brunogle/me1-proyecto/informes/paper/main.pdf

# Lectura y procesamiento digital de senales ˜ electrocardiograficas ´

1

er Bruno Glecer

UTN - FRBA
Buenos Aires, Argentina
bglecer@frba.utn.edu.ar

2

do Uriel Sandomir

UTN - FRBA
Buenos Aires, Argentina
usandomir@frba.utn.edu.ar

3

ero Jonathan Yujra

UTN - FRBA
Buenos Aires, Argentina
jonathany@frba.utn.edu.ar
Abstract—La tecnica de la lectura de se ´ | nales el ˜ | ectricas produci- ´
das por el corazon se conoce como electrocardiograf ´ | ía, y es una
parte importante de la medicina moderna. En esta publicacion´ demostramos un circuito basico capaz de captar y digitalizar ´
senales card ˜ | íacas mediante el uso de un par de electrodos
colocados sobre un paciente, conocido como electrocardiografía
de unica derivaci ´ | on. ´
Index Terms—ECG, bioengineering, filtering, DSP
I. INTRODUCCION´
La tecnica de electrocardiograf ´ | ía (ECG) comienza en los
fines del siglo XIX con metodos basados en galvan ´ | ometros ´
especialmente sensibles y rapidos, con los que se fue de- ´ sarrollando los fundamentos de la electrocardiología. Estos
metodos fueron superados por electrocardi ´ | ografos que uti- ´
lizaban valvulas termoi ´ | onicas para la amplificaci ´ | on de las ´
senales, y estas fueron naturalmente remplazadas por el uso ˜ del transistor. Al día de hoy las senales t ˜ ípicamente son digitalizadas por un conversor analogico digital (ADC) y procesadas ´ digitalmente para mejorar su claridad. En la actualidad, existen metodos que un especialista puede utilizar para analizar el ´
estado de un corazon a base de las se ´ | nales obtenidas por un ˜
electrocardiografo, esto t ´ | ípicamente se realiza con mediciones
tomadas por multiples electrodos para lograr una mayor dis- ´
criminacion entre las actividades del ciclo card ´ | íaco. [1]

II. FUNDAMENTOS BIOLOGICOS ´

A. Origen de la actividad electrica del coraz ´ | on´
El corazon es un ´ | organo vital presente en la mayor ´ | ía de los
animales que cumple la funcion de circular sangre a trav ´ | es de ´
las arterias y venas con el fin de transportar oxígeno y nutrientes a la gran mayoría de las partes del cuerpo. El corazon´ esta principalmente compuesto por tejido muscular que se ´ contrae y relaja en forma coordinada, la secuencia en el que lo realiza se conoce como el ciclo cardíaco. Las contracciones
son causadas por senales el ˜ | ectricas producidas por el ´ | nodulo ´
sinoauricular. Debido a que la naturaleza de estas senales es ˜
electrica, y debido a que los tejidos h ´ | umedos incluyendo la ´
piel tienen una conductividad electrica considerable, es posible ´ realizar mediciones de estas senales de forma no invasiva ˜

Agradecemos a la Universidad Tecnologica Nacional por permitirnos el uso ´ de sus instalaciones y recursos para realizar nuestro proyecto, y a los docentes de la materia Medidas Electronicas I: Pablo De Cesare, Franco Zaccra y ´ Ramiro German Rodriguez Colmeiro por su apoyo durante el trabajo ´

mediante la colocacion de electrodos en la regi ´ | on cercana ´
al corazon. Observando las se ´ | nales es posible identificar las ˜
distintas etapas del ciclo cardíaco, y con suficiente pericia, reconocer la salud del organo. ´
Para mayor comprension, a continuaci ´ | on describiremos las ´
etapas mas importantes del ciclo card ´ | íaco y como se relacionan
con una senal electrocardiogr ˜ | afica: [2] ´
- Sístole auricular (Onda P): Durante esta etapa las cavidades superiores llamadas aurículas se contraen para enviar la sangre a las respectivas cavidades inferiores llamadas ventrículos. La aurícula derecha recibe sangre desoxigenada del cuerpo, mientras la aurícula izquierda recibe sangre recientemente oxigenada, directo de los pulmones.
Este evento da origen a una senal denominada ˜ | onda P
- Sístole ventricular (Complejo QRS): Durante esta etapa los ventrículos se contraen para expulsar la sangre al
exterior del corazon. El ventr ´ | ículo derecho envía su
sangre desoxigenada hacia los pulmones, mientras que el ventrículo izquierdo envía su sangre oxigenada al resto del cuerpo. Esta etapa es compleja, y su representacion´ electrica puede variar, pero suele estar compuesta por un ´
pico negativo pequeno denominado ˜ | onda Q, seguido de
un pulso positivo de alta amplitud denominado onda R y seguido de otro pulso negativo denominado onda S. El conjunto de estas tres ondas, se las denomina complejo QRS.
Dependiendo del estado del corazon, la onda Q y la onda ´ S pueden estar o no presentes, mientras que la onda R siempre esta presente y corresponde al punto de mayor
actividad electrica del coraz ´ | on en todo su ciclo. ´
- Diastole Ventricular (Onda T) ´ | : En esta etapa los
ventrículos se relajan, preparando el corazon para el sigu- ´
iente ciclo. La relajacion de los ventr ´ | ículos se presenta
electricamente como una onda similar a la onda P. A esta ´ onda se la denomina onda T.
En la figura 1 se muestra un diagrama de una senal ECG ˜ típica.
B. Características de la senal el ˜ | ectrica ´
Las senales el ˜ | ectricas captadas por los electrodos tienen ´
amplitudes en el rango de 1-3 mV, dependiendo de la ubicacion´
de los electrodos, su tamano, caracter ˜ | ísticas de la piel del

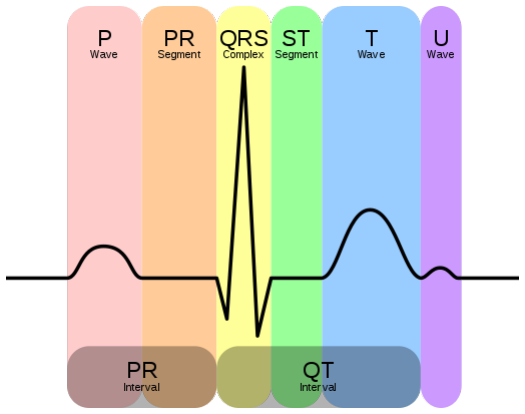
[picture p26: figure]

Fig. 1. Ejemplo de una senal de ECG t ˜ | ípica. La ultima onda ”U” no suele ´
ser visible debido a su pequena amplitud, y su naturaleza no est ˜ | a totalmente ´
comprendida.

paciente, entre otros factores difíciles de controlar. Ademas, ´
se conoce que el rango de frecuencias de interes de la se ´ | | nal ˜
es de entre 0.05 Hz y 200 Hz. Por otro lado, la impedancia de salida de la senal puede rondar los cientos de kiloohmios, ˜ lo cual exige una impedancia de entrada alta para el correcto funcionamiento de un electrocardiografo. [3] [4] ´

III. METODOLOGÍA GENERAL

A. Objetivo de medicion´
Nuestra meta para este trabajo fue el diseno y construcci ˜ | | on´
de un electrocardiografo capaz de captar una se ´ | nal card ˜ | íaca
con la suficiente calidad para lograr distinguir la onda P, T y el complejo QRS y de mostrar los valores temporales y de amplitud lo mas precisamente posible. ´
Por simplicidad, se eligio que su entrada sea de ´ | unica ´
derivacion (un solo par de electrodos). ´
B. Acondicionamiento analogico ´
La senal captada por los electrodos debe ser amplificada y ˜
filtrada analogicamente antes de ser digitalizada. La elecci ´ | | on´
de la primera etapa de amplificacion es cr ´ | ítica: es especial-
mente importante que sea de bajo ruido, debido a la pequenã
senal de entrada, y tiene que operar con m ˜ | | | ínimo consumo
de corriente de polarizacion de entrada, debido a la alta ´ impedancia de salida de la senal. ˜
El diseno de esta etapa puede ser complicada y requiere ˜ implementarse en un PCB con consideraciones de disenõ especiales. Para optimizar el proceso, decidimos reutilizar un
modulo para captar se ´ | nales biol ˜ | ogicas dise ´ | nado y armado ˜
por el grupo de investigacion´ GIBIO en la UTN-FRBA. Este
modulo ya tiene dise ´ | nada una etapa de entrada completa que ˜
podemos utilizar para este proposito y un ADC espec ´ | ífico para
captar senales de ECG, pero desafortunadamente el ADC no ˜ se encontraba funcionando correctamente, entonces nos vimos obligados a utilizar un ADC externo.
El modulo consiste de una etapa de entrada utilizando ´ el amplificador operacional ADA4530 fabricado por Analog Devices como primera etapa, seguido de una etapa de filtrado de altas frecuencias, seguido de una etapa de ganancia configurable mediante el uso de resistencias variables y finalmente una etapa para desplazar la senal hacia valores positivos y ˜ centrarla en 1.65 V, esto es necesario, ya que la referencia negativa del ADC es de 0 V.
El amplificador operacional ADA4530 [5] es un perfecto candidato para la primera etapa de amplificacion. Tiene una ´
corriente de polarizacion de entrada de 20 fA. Adem ´ | as, ´
proporciona un terminal de ”guard” que permite reducir las
perdidas parasitas de la se ´ | nal hacia la masa del circuito. ˜
La figura 2 muestra el esquematico simplificado del m ´ | odulo ´
analogico. ´
Un problema de diseno de este m ˜ | odulo, es que no tiene una ´
frecuencia de corte superior lo suficientemente baja como para actuar de filtro anti-alias. Esto puede ser perjudicial para nue-
stro objetivo y una nueva iteracion del circuito resolver ´ | ía este
error, sin embargo, no se cree que esta falla del diseno cause ˜ mayores complicaciones, debido a que las unicas componentes ´ espectrales por encima de la frecuencia de Nyquist del ADC y por debajo de la frecuencia de corte del modulo, consisten de ´ ruido uniformemente distribuido, lo cual en efecto, introducirá

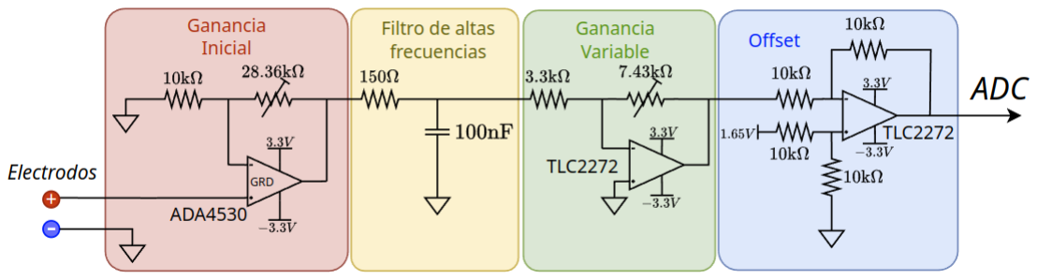
[picture p27: figure]

Fig. 2. Esquematico simplificado de la etapa anal ´ | ogica del m ´ | odulo desarrollado por el GIBIO en la UTN-FRBA. ´

mas ruido en la conversi ´ | on, pero no causar ´ | a artefactos de alias ´
que puedan confundirse con la senal ECG. ˜
Dos de las etapas tienen ganancia ajustable mediante el uso de resistencias variables. Estas resistencias fueron ajustadas y luego medidas, sus valores se encuentran en la figura 2, estos
valores daran lugar a una ganancia te ´ | orica de 8.631 veces. ´
Este valor fue el utilizado para realizar la calibracion m ´ | as´
adelante. Su valor exacto no es de gran importancia, ya que la
calibracion contempla la compensaci ´ | on por su incertidumbre ´
C. Conversion A/D ´
Para convertir la senal anal ˜ | ogica entregada por el m ´ | odulo ´
analogico a una se ´ | nal digital necesitamos de un ADC capaz ˜
de muestrear como mínimo al doble de la frecuencia maxima ´ presente en una senal ECG (alrededor de 400 muestras por ˜ segundo) para cumplir con el criterio de Nyquist y con una resolucion menor a 1 mV para lograr una buena calidad de la ´ senal. ˜
Se decidio utilizar el ADC ADS1115 de Texas Instruments ´
[6] que adquirimos ya montando sobre una placa con los componentes auxiliares que necesita el circuito integrado ya colocados.
Este ADC tiene una frecuencia de muestreo maxima de 860 ´ muestras por segundo, resolucion de 16 bit y una interfaz I ´

2C.
Este ADC fue elegido por su gran disponibilidad, facilidad de uso y tambien porque cumple con nuestro requisito de ser ´ capaz de muestrear por arriba de los 400 Hz.
El ADS1115 fue configurado en modo single-shot para utilizar la base de tiempo del microcontrolador. Estara operando ´
a 500 muestras por segundo. En terminos de resoluci ´ | on, la ´
tension de referencia positiva fue configurada para utilizar ´ la referencia interna de 4.096 V, y 0 V como referencia
negativa. Esta configuracion permite una resoluci ´ | on te ´ | orica de ´
4.096V
2

16 = 62.5µV .

D. Interfaz PC-ADC

Para configurar y comunicar los resultados del ADS1115 con una computadora, es necesario el uso de un microcontrolador. Decidimos utilizar una placa de desarrollo de ST Microelectronics: La Nucleo F401-RE [7]. Esta placa está basada sobre un microcontrolador STM32F401RE, este es un ARM Cortex-M4 de 32 bit con una frecuencia de reloj maxima ´ de 84 MHz. Este microcontrolador esta sobredimensionado ´
para esta aplicacion, pero aun as ´ | í lo utilizamos porque el
grupo ya tenía experiencia previa con esta placa de desarrollo en particular y lo pudimos obtener con facilidad mediante la universidad.
De este microcontrolador utilizamos principalmente un puerto I²C para la comunicacion con el ADS1115, un timer ´
interno con una interrupcion para poder iniciar una conversi ´ | on´
con una frecuencia de 500 Hz y un puerto UART que la placa de desarrollo utiliza para crear un enlace con la PC mediante el puerto USB.
El programa ejecutandose en el microcontrolador realiza la ´
configuracion inicial del ADS1115, su lectura peri ´ | odica y la ´

transmision de los resultados de las conversiones del ADC ´ mediante un puerto serie.
El codigo fuente y los binarios utilizados se encuentra en ´ el repositorio del proyecto. [8]
E. Software PC
Para la visualizacion de la se ´ | nal, se desarroll ˜ | o una interfaz ´
grafica programada en Python utilizando la librer ´ | | ía PyQt5.
El programa recibe los datos de las conversiones del ADC mediante la interfaz del puerto serie establecido a traves de ´ USB con el microcontrolador.
La senal recibida por la PC en este punto del proceso ˜ tiene una mala relacion se ´ nal a ruido, dificultando mucho su ˜ visualizacion. Para mejorar esto se emplea el uso de filtros ´ digitales para reducir el ruido, en particular, los ruidos que
típicamente estan presentes en la se ´ | nal son: Interferencias de ˜
50 o 60 Hz causado por la frecuencia de línea, ruido de baja frecuencia causado por cambios en la conductividad electrica ´ de la piel del paciente y ruido en todo el espectro causado por varias fuentes de interferencia.
Para mitigar cada una de estas fuentes de ruido, utilizamos dos tipos de filtros digitales en cascada. Primero, se aplica un filtro notch con frecuencia central de 50 Hz y selectividad de 2. Y segundo, un filtro Butterworth pasabanda de segundo orden con frecuencias de corte en 0.5 Hz y 100 Hz. Excepto por la frecuencia central del primer filtro notch, los otros valores fueron elegidos experimentalmente para mejorar la claridad de la senal. Los valores del filtro pasa banda recortan parte del ˜
espectro de interes de la se ´ | nal, aun as ˜ | í, la reduccion de ruido ´
que acompana esta limitaci ˜ | on beneficia la claridad de la se ´ | nal. ˜


Fig. 3. Fotografía del proyecto en su gabinete.

IV. CALIBRACION´

A. Necesidad

El electrocardiografo desarrollado tiene varias fuentes de ´ incertidumbre, las mas relevantes son la transferencia entre la ´ entrada y la senal digitalizada, y la base de tiempo utilizada ˜

para muestrear la senal. Para que las interpretaciones del elec- ˜ trocardiograma puedan ser precisas es necesario tener buena linealidad en la transferencia y temporizaciones precisas. El objetivo de la calibracion es obtener dos factores: Un factor ´
de correccion temporal que denominaremos ´ | αT , que especifica
proporcionalmente cuanto esta desviada la base de tiempo del ´
electrocardiografo, y un factor de calibraci ´ | on de amplitud que ´
denominaremos αA, que especifica la diferencia relativa entre la ganancia teorica del sistema y la real. ´
Una vez que se obtienen estos valores, cualquier analisis que ´
se realice sobre una senal obtenida por el electrocardi ˜ | ografo, ´
se puede corregir multiplicando por el factor de correccion´ que corresponda al tipo de medicion. ´
Otra necesidad de conocer con exactitud la base de tiempo es para el uso de los filtros. Estos depende de conocer con precision la frecuencia de muestreo del ADC. El rendimiento ´ del filtro notch de 50 Hz es particularmente sensible a una desviacion en la frecuencia de muestreo. ´
B. Metodo ´
Para evaluar el desempeno del electrocardi ˜ | ografo, se utiliz ´ | ó
un generador de funciones Agilent 33522A con su calibracion´
de fabrica como referencia para generar una se ´ | nal electrocar- ˜
diografica de duraci ´ | on y amplitud conocida. ´
El instrumento se controlo mediante un script en Python que ´ itera por varias opciones de amplitud y frecuencia cardíaca, cargando la senal al instrumento el cual su salida fue conectada ˜ directamente a la entrada del electrocardiografo. Para cada una ´ de estas configuraciones de frecuencia cardíaca y amplitud se tomaron 10 muestras de 10 segundos cada una utilizando el electrocardiografo y fueron guardadas en archivos para luego ´ procesar.
Una vez obtenidas las senales se les aplic ˜ | o los mismos filtros ´
que el programa de la visualizacion utiliza para limpiar la ´ senal. ˜
Las senales proporcionadas al generador de ondas arbi- ˜ trario fueron sintetizadas utilizando la librería de Python neurokit2. [9] Esta misma librería se utilizo luego para ´
analizar las senales captadas por el electrocardi ˜ | ografo. ´
De las senales captadas se midieron dos par ˜ | ametros para ´
estudiar el rendimiento:
Primero, la frecuencia cardiaca, este valor es un parametro ´
biologico clave estudiado en la electrocardiograf ´ | ía, y ademas´
proporciona un valor que tiene una correlacion perfectamente ´ lineal con la base de tiempo del electrocardiografo, una ´ posible fuente de error. Fue medido utilizando la funcion´
ecg_process de neurokit2 con el metodo de detecci ´ | on´
de picos ”engzeemod2012” y promediando el valor de ritmo cardíaco a lo largo del vector de salida.
Y como segundo parametro, se midi ´ | o la diferencia entra la ´
amplitud promedio de los pulsos R y la amplitud promedio de los pulsos S. Los pulsos tambien fueron detectados utilizando ´
la funcion´ ecg_process con el mismo metodo de detecci ´ | on´
de picos que su uso para obtener la frecuencia cardiaca. Este ´
parametro es ´ | util, debido a que representa una buena medici ´ | on´
de la amplitud pico a pico de la senal, ya que los pulsos S ˜
son los puntos mas bajos de la se ´ | nal y los pulsos R los m ˜ | as´
altos.
La calibracion se realiz ´ | o para las frecuencias cardiacas de: ´
50, 75, 100, 200 y 250 latidos por minuto, y amplitudes de 0.002, 0.005, 0.01, 0.02 y 0.1 V. Para cada una de estas combinaciones se realizaron 10 muestras de 10 segundos cada una, resultando en un total de 250 muestras. La mitad de estas muestras fueron destinadas para la calibracion, mientras que ´
la otra mitad se utilizo para la verificaci ´ | on de la calibraci ´ | on. ´
Es importante no reutilizar las mismas muestras para calibrar
y para verificar debido a que esto producira una verificaci ´ | on´
de la calibracion sesgada. ´
Una vez que se obtuvieron las mediciones de la calibracion, ´ estos se compararon con los valores teoricos para calcular ´ ambos factores de correccion. ´
Mas espec ´ | íficamente, cada factor se calculo utilizando la ´
media aritmetica de todos los errores relativos: ´

αT =

1
N

X

(a,f,n)∈A×F ×{1...10}

f

ˆf(a,f,n)

αA =

1
N

X

(a,f,n)∈A×F ×{1...10}

a

â(a,f,n)

Donde A y F son respectivamente los conjuntos de amplitudes y frecuencias cardiacas utilizadas para calibrar. ˆf(a,f,n)
y â(a,f,n) es el valor medido durante la calibracion de la ´ | n-
esima muestra para una amplitud de a y frecuencia cardíaca de f. N = 125 es la cantidad total de muestras medidas (5 frecuencias cardiacas, 5 amplitudes y 5 muestras por combinacion). ´
Ademas, para cada uno de estos factores, es relevante ´ conocer su incertidumbre, para esto calculamos el desvío
estandar de la media de cada uno. Las f ´ | ormulas utilizadas ´
son las siguientes:


Fig. 4. Calibracion del proyecto en progreso. La medici ´ | on de las 250 muestras ´
demoro aproximadamente una hora. ´

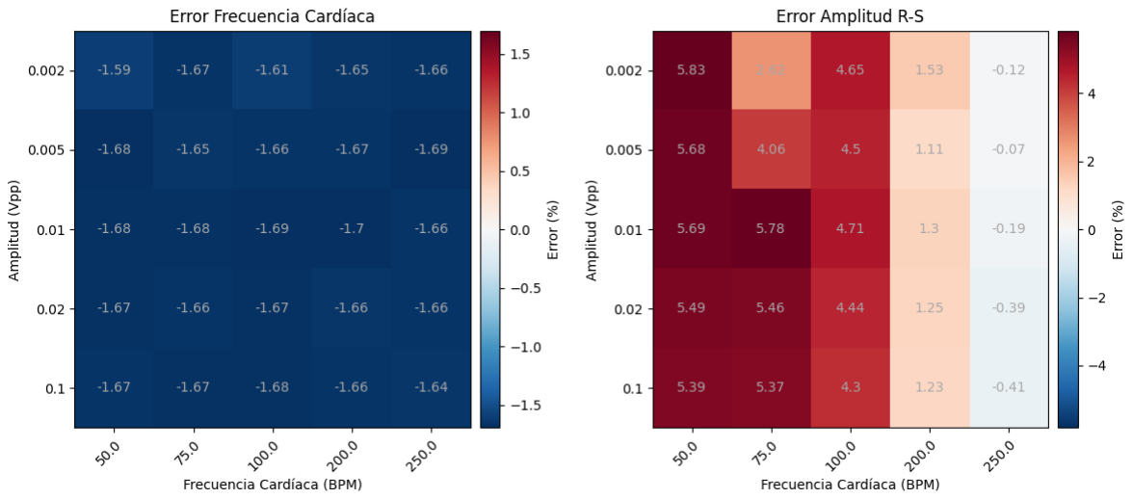
[picture p28: figure]

Fig. 5. Mapa de error de medicion sin la calibraci ´ | on aplicada. ´

u

2

(αT ) = 1 N − 1
X

(a,f,n)∈A×F ×{1...10}

f

ˆf(a,f,n)

− αT

!2

u

2

(αA) = 1 N − 1
X

(a,f,n)∈A×F ×{1...10}

a

â(a,f,n)

− αA

2

En todos los casos, la incertidumbre se dara en forma ´ expandida con un factor de cobertura k = 2, es decir, con una confianza del 95%:

U(α) = ku(α)

Una vez que se obtienen estos factores de calibracion, se ´ pueden utilizar para ajustar cualquier medicion realizada con ´ el electrocardiografo utilizando las siguientes conversiones: ´

F

′ = αT F

T

′ =

T
αT

A

′ = αAA

Donde F indica algun par ´ ametro frecuencial medido, como ´ ser pulsaciones por minuto, T indica un parametro temporal ´
medido como ser separacion entre pulsos, y ´ | A indica un
parametro de amplitud. ´ | F

′
, T

′ y A′
indican los valores
corregidos de F, T y A respectivamente.
Otra forma de aplicar una correccion es modificar la se ´ | nal ˜
previo al analisis de la siguiente forma: ´

v

′
(t) = αA v(αT t)
Donde v(t) representa la senal original y ˜ | v

′
(t) la senal ˜
corregida.
C. Resultados de la calibracion´
La figura 5 muestra para cada frecuencia y amplitud, el
error relativo medio entre la medicion de cada par ´ | ametro, y el ´
esperado.
Analizando cualitativamente el grafico de error de frecuen- ´ cia cardíaca, vemos que este es muy consistente a lo largo de las frecuencias y amplitudes probadas, todos los valores de error estan dentro de un rango del 1.6% al 1.7%. ´
De lo contrario, vemos que el error de amplitud no es consistente y varía dependiendo de la frecuencia cardíaca. Utilizando las ecuaciones planteadas en la subseccion ante- ´ rior, procedemos a calcular los factores de correccion. ´

αT = 1.01692 ± 0.00088

αA = 0.969 ± 0.048

D. Rendimiento de la calibracion´
Una vez obtenido los factores de correccion, estos valores ´ se pueden utilizar para refinar el desempeno del electro- ˜
cardiografo calibrado. Procedemos a realizar el mismo an ´ | alisis ´
que se realizo para la calibraci ´ | on con el paso adicional de ´
aplicar los factores de correccion previo al an ´ | alisis de las ´
senales. ˜
Esto resulta en el mapa de error visualizado en la figura 6. Los errores de la frecuencia cardíaca se encuentran dentro de un rango del -0.04% al 0.02%, mientras que los errores de
amplitud tienen mas dispersi ´ | on y, como es de esperar, siguen ´
manteniendo la correlacion entre error y frecuencia card ´ | íaca
que se observo previo a la calibraci ´ | on. Los valores de este ´
parametro existen en el rango de -3.6% al 2.9%. ´

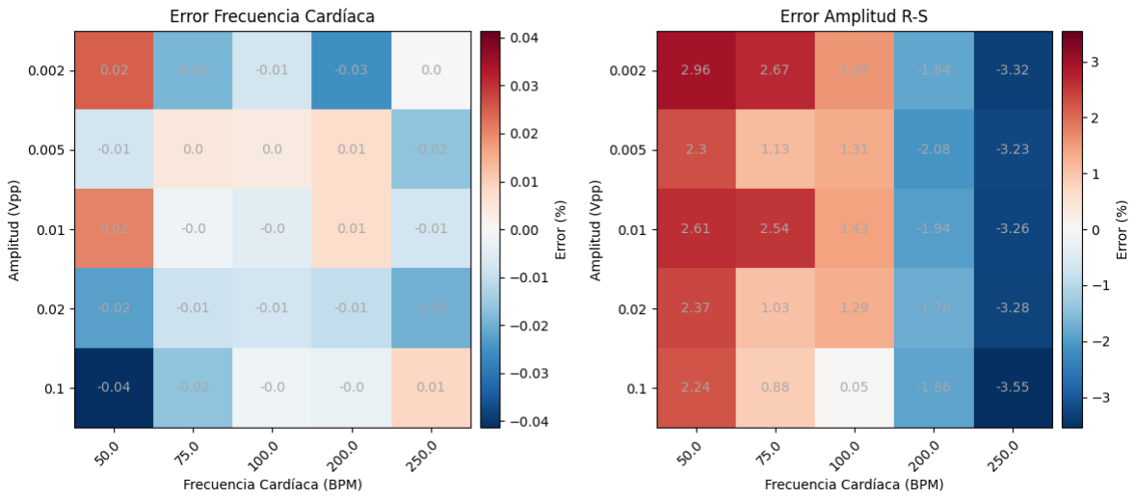
[picture p29: figure]

Fig. 6. Mapa de error de medicion con la calibraci ´ | on aplicada. ´

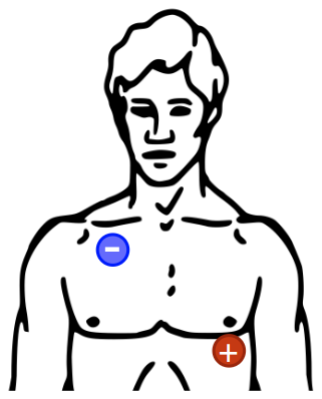
[picture p30: figure]

Fig. 7. Diagrama de la colocacion recomendada de los electrodos. ´

V. PRUEBA DE UNA MEDICION REAL ´

Una vez obtenidos los factores de correccion, estos fueron ´
cargados al programa que se describio en la secci ´ | on III-E. ´
La ubicacion de los electrodos es una parte cr ´ | ítica de la
electrocardiografía, basandonos en la literatura y realizando ´ comparaciones cualitativas de la calidad de la senal obtenida, ˜ determinamos que la mejor colocacion de los electrodos para ´ este caso es la ilustrada en la figura 7
Una vez ubicados los electrodos, y conectados al electrocardiografo se puede utilizar el programa para visualizar la ´ senal obtenida. ˜
En la figura 8 se muestra una captura de pantalla del graficador mostrando la senal ECG captada de uno de los ˜ integrantes del proyecto.

VI. CONCLUSIONES

Analizando el error de frecuencia cardíaca previo a la calibracion se puede observar en el mapa de error de la figura ´

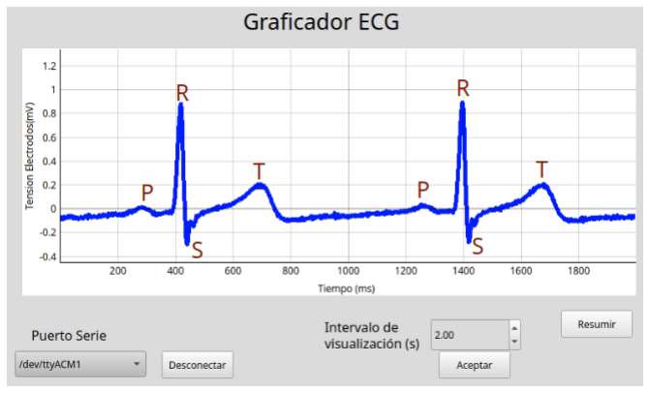
[picture p31: figure]

Fig. 8. Captura de pantalla tomada por la medicion del electrocardi ´ | ografo ´
sobre uno de los integrantes del grupo. Se etiquetaron los pulsos claves.

6 que no varía dependiendo de frecuencia cardiaca ni de la amplitud. Esto es un indicador fuerte de que la fuente de esta diferencia es la frecuencia a la que el ADC se encuentra muestreando. Un estudio del microcontrolador podría dar mas´
informacion al respecto. Luego de la calibraci ´ | on, el error de ´
frecuencia cardiaca permanece debajo del 0.04%, una cifra muy buena indicando consistencia entre diferentes condiciones de medicion. ´
En terminos de la amplitud, la correlaci ´ | on negativa del valor ´
medido con la frecuencia cardiaca puede ser un indicio de que la senal alcanza su valor pico entre dos muestras del ADC. El ˜ comportamiento esperado de esta situacion es que disminuya ´ con un incremento de frecuencia, que es precisamente lo que se observa que sucede. Para estudiar esto es necesario analizar
la forma de onda con mas precisi ´ | on y remplazar el ADC ´
por uno que soporte frecuencias de muestreo mas altas. La ´

calibracion ayud ´ | o a que el error de amplitud se encuentre ´
mas uniformemente disperso entre las distintas frecuencias ´ cardíacas.
Otro valor de interes para observar es la incertidumbre de los ´ factores de correccion. Como es de esperar, la incertidumbre ´ relativa de αT es extremadamente bajo, alrededor de 0.08%, indicando que las mediciones de tiempo son muy precisas. En cambio, la incertidumbre relativa de αA es aproximadamente 11%.
La prueba de medicion de una se ´ | nal ECG real result ˜ | ó
sorprendentemente exitosa, la visualizacion de la se ´ | nal permite ˜
identificar con claridad los pulsos P, R, S y T. El pulso Q no aparenta estar presente, esto se puede deber a una
combinacion de factores, incluyendo la colocaci ´ | | on de los ´
electrodos y el estado del paciente, no necesariamente indica
una limitacion del electrocardi ´ | ografo. Aun as ´ | í, no descartamos
la posibilidad de que simplemente se mezcle con el ruido, esto podría verificarse utilizando un equipo electrocardiografico ´ profesional.

REFERENCES

[1] L. | J. | AlGhatrif | M, | “A | brief | review: | history | to | un-
derstand | fundamentals | of | electrocardiography,” | J | Community
Hosp | Intern | Med | Perspect., | 2012. | [Online]. | Available:
https://www.ncbi.nlm.nih.gov/pmc/articles/PMC3714093/
[2] N. J. Ashley EA, Cardiology Explained. Remedica, 2004. [Online]. Available: https://www.ncbi.nlm.nih.gov/books/NBK2214/
[3] Q. | U. | D. | of | Emergency | Medicine, | “Analy-
sis | and | interpretation | of | the | electrocardiogram.” | [On-
line]. Available: https://elentra.healthsci.queensu.ca/assets/modules/tsecg/normal ecg.html
[4] Z. B. Murugappan M, Murugappan S, “Frequency band analysis of electrocardiogram (ecg) signals for human emotional state classification using discrete wavelet transform,” J Phys Ther Sci., 2013. [Online]. Available: https://www.ncbi.nlm.nih.gov/pmc/articles/PMC3820413/
[5] A. | Devices, | “Data | sheet | ada4530-1.” | [Online]. | Avail-
able: | https://www.analog.com/media/en/technical-documentation/data-
sheets/ADA4530-1.pdf
[6] T. | Instruments, | “Data | sheet | ads111x.” | [Online]. | Available:
https://www.ti.com/lit/ds/symlink/ads1114.pdf
[7] “Stm32 | nucleo-64 | development | board.” | [Online]. | Available:
https://www.st.com/en/evaluation-tools/nucleo-f401re.html
[8] “Trabajo practico - medidas electr ´ | onicas 1.” [Online]. Available: ´
https://github.com/brunogle/me1-proyecto
[9] “Neurokit2: The python toolbox for neurophysiological signal processing.” [Online]. Available: https://github.com/neuropsychology/NeuroKit
