brunogle/me1-proyecto/soft/calibration/output/amplitude_corr.png

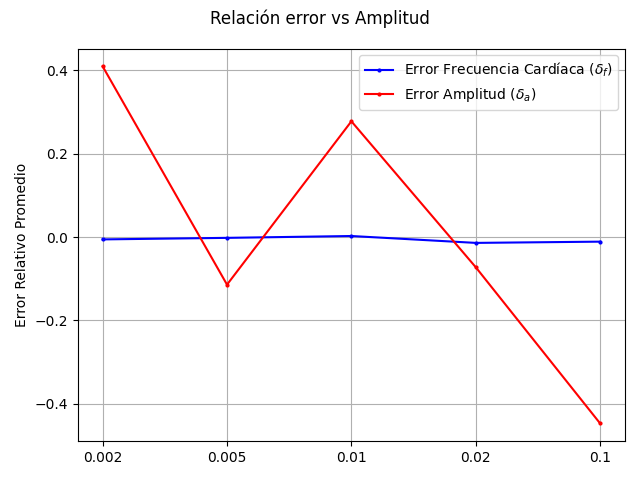
soft/calibration/output/amplitude_corr.png
