brunogle/me1-proyecto/soft/calibration/output/heart_rate_corr.png

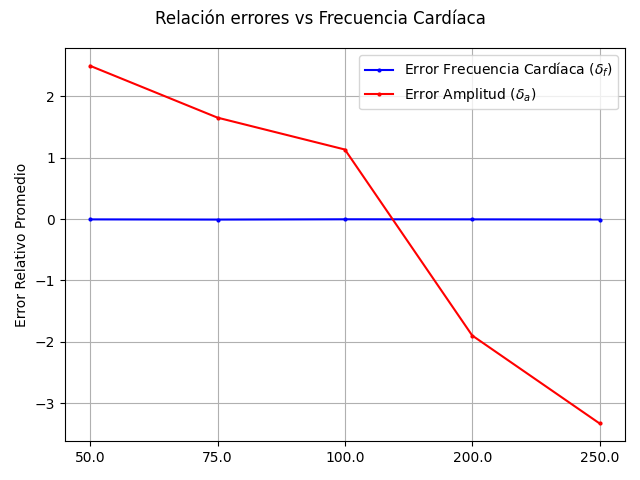
soft/calibration/output/heart_rate_corr.png
