brunogle/me1-proyecto/design/adquisidor-master/FrontEnd/FrontEnd.kicad_pcb

## KiCad design design/adquisidor-master/FrontEnd/FrontEnd.kicad_pcb (2023-10-05, last stored version)

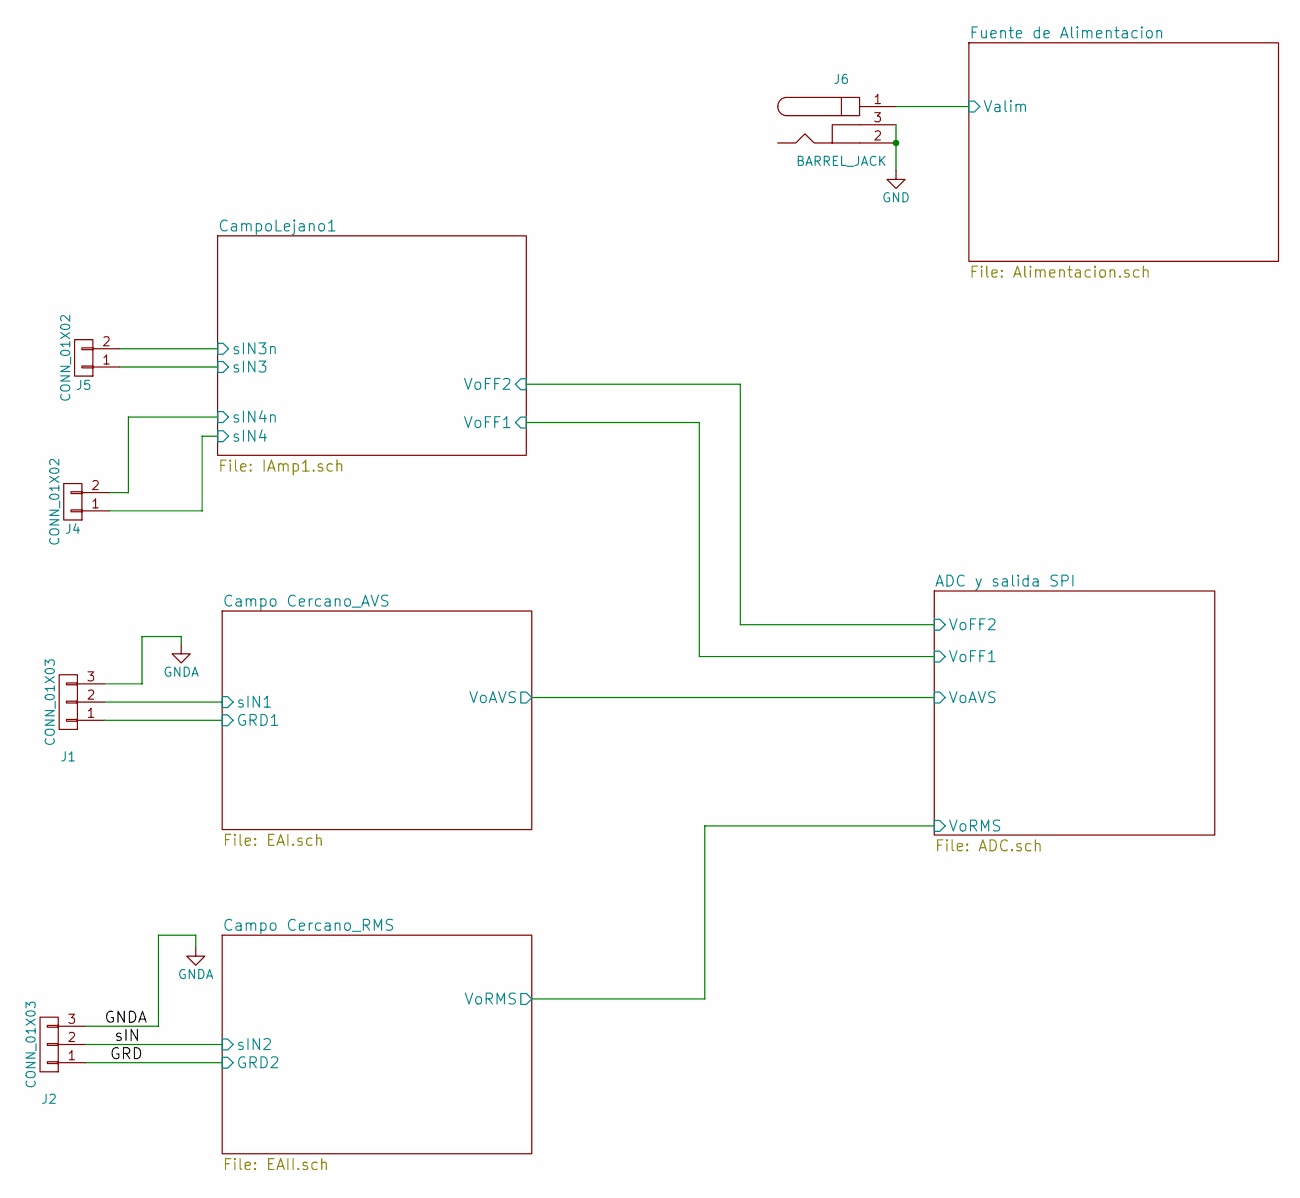
[picture p55: schematic FrontEnd.sch]

Parts:
J1, J2: CONN_01X03; Triaxial_PAD
J4, J5: CONN_01X02; TerminalBlock_bornier-2_P5.08mm
J6: BARREL_JACK

Connections:
+5V: J6.1; also elsewhere on the board
/Campo Cercano_AVS/GRD1: J1.1; also elsewhere on the board
/Campo Cercano_AVS/sIN1: J1.2; also elsewhere on the board
/Campo Cercano_RMS/GRD2: J2.1; also elsewhere on the board
/Campo Cercano_RMS/sIN2: J2.2; also elsewhere on the board
/CampoLejano1/sIN3: J5.1; also elsewhere on the board
/CampoLejano1/sIN3n: J5.2; also elsewhere on the board
/CampoLejano1/sIN4: J4.1; also elsewhere on the board
/CampoLejano1/sIN4n: J4.2; also elsewhere on the board
GND: J6.2, J6.3; also elsewhere on the board
GNDA: J1.3, J2.3; also elsewhere on the board

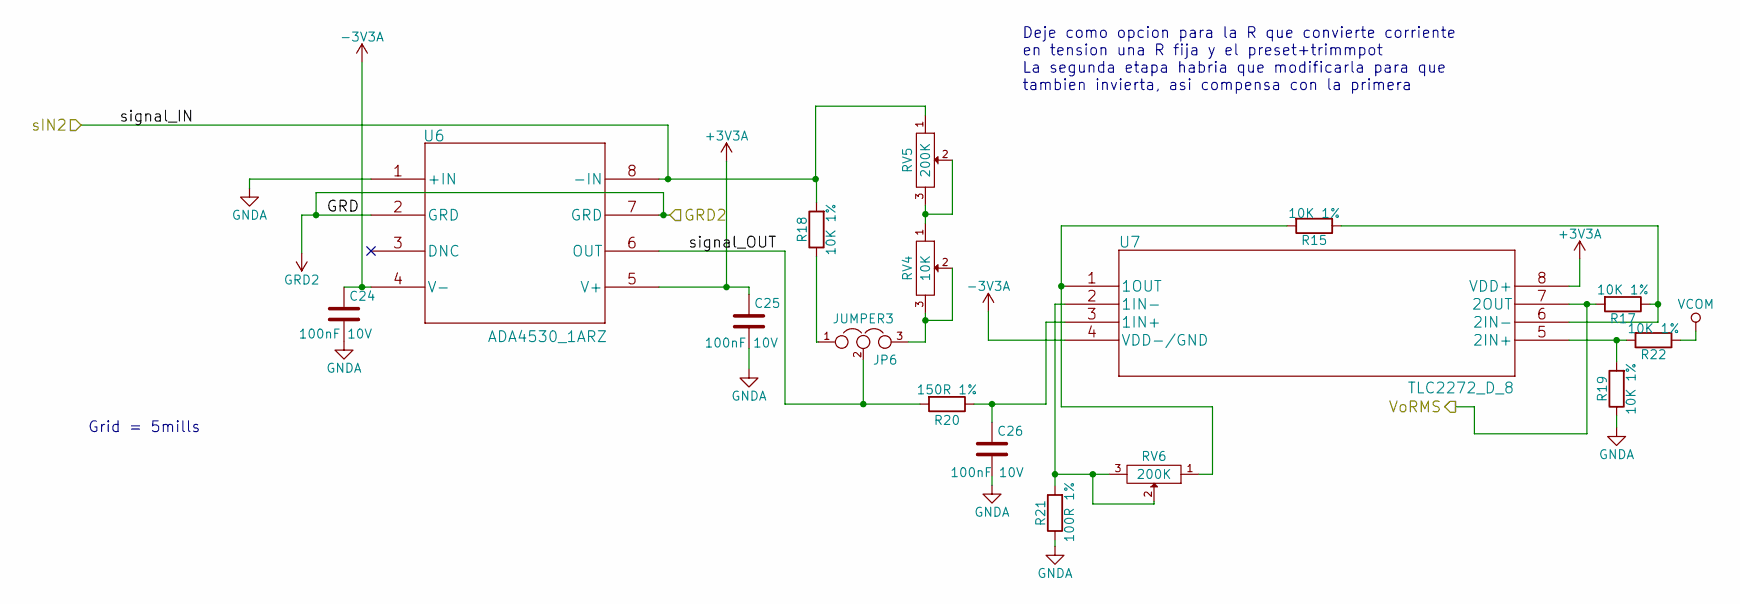
[picture p56: schematic EAII.sch]

Parts:
C24, C25, C26: 100nF 10V; C_0603; Part N 06033C104KAT4A; DigiKey 478-7018-2-ND
JP6: JUMPER3; Pin_Header_Straight_1x03_Pitch2.00mm
R15, R17, R18, R19, R22: 10K 1%; R_0603; Part N CRG0603F10K; DigiKey A106048TR-ND
R20: 150R 1%; R_0603; Part N CRGCQ0603F150R; DigiKey A130404CT-ND
R21: 100R 1%; R_0603; Part N CRGP0603F100R; DigiKey A130404CT-ND
RV4: 10K; Potentiometer_Trimmer_Bourns_3269W; Part N 3269W-1-103GLF; DigiKey 3269W-1-103GLFCT-ND
RV5, RV6: 200K; Potentiometer_Trimmer_Vishay_TS53YJ; Part N TS53YL204MR10; DigiKey TS53YL-200KCT-ND
U6: ADA4530_1ARZ; Part N ADA4530-1ARZ; DigiKey ADA4530-1ARZ-ND
U7: TLC2272_D_8; Part N TLC2272ACDR; DigiKey 296-1303-1-ND

Connections:
+3V3A: C25.1, U6.5 (V+), U7.8 (VDD+); also elsewhere on the board
-3V3A: C24.1, U6.4 (V-), U7.4 (VDD-/GND); also elsewhere on the board
/ADC y salida SPI/VoRMS: R17.2, U7.7 (2OUT); also elsewhere on the board
/Campo Cercano_RMS/GRD2: U6.2 (GRD), U6.7 (GRD); also elsewhere on the board
/Campo Cercano_RMS/sIN2: R18.2, RV5.1, U6.8 (-IN); also elsewhere on the board
/Campo Cercano_RMS/signal_OUT: JP6.2, R20.2, U6.6 (OUT)
GNDA: C24.2, C25.2, C26.2, R19.1, R21.1, U6.1 (+IN); also elsewhere on the board
unnamed: C26.1, R20.1, U7.3 (1IN+)
unnamed: JP6.1, R18.1
unnamed: JP6.3, RV4.2, RV4.3
unnamed: R15.1, R17.1, U7.6 (2IN-)
unnamed: R15.2, RV6.1, U7.1 (1OUT)
unnamed: R19.2, R22.2, U7.5 (2IN+)
unnamed: R21.2, RV6.2, RV6.3, U7.2 (1IN-)
unnamed: RV4.1, RV5.2, RV5.3
VCOM: R22.1; also elsewhere on the board

Notes on the sheet:
Grid = 5mills
Deje como opcion para la R que convierte corriente en tension una R fija y el preset+trimmpot La segunda etapa habria que modificarla para que tambien invierta, asi compensa con la primera

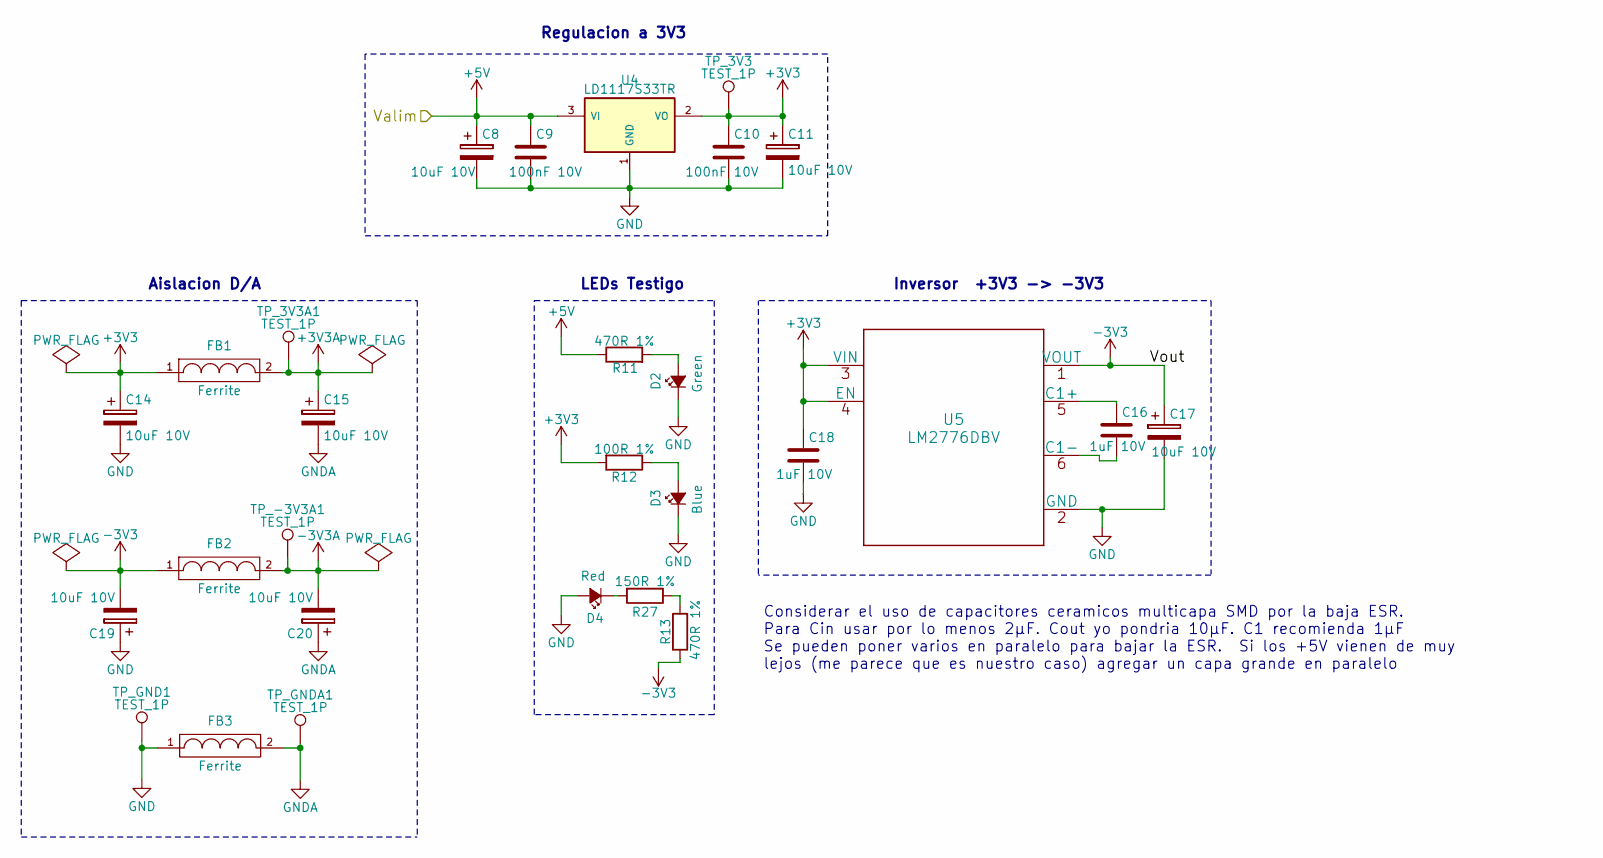
[picture p57: schematic Alimentacion.sch]

Parts:
C8, C11, C14, C15, C17, C19, C20: 10uF 10V; C_0603; Part N 0603ZD106KAT2A; DigiKey 478-10766-2-ND
C9, C10: 100nF 10V; C_0603; Part N 06033C104KAT4A; DigiKey 478-7018-2-ND
C16, C18: 1uF 10V; C_0603; Part N CL10A105MP8NNNC; DigiKey 1276-1866-2-ND
D2: Green; LED_0603; Part N LT Q39G-Q1OO-25-1; DigiKey 475-3442-1-ND
D3: Blue; LED_0603; Part N LB Q39G-L2OO-35-1
D4: Red; LED_0603; Part N LS L29K-H1J2-1-Z; DigiKey 475-1195-1-ND
FB1, FB2, FB3: Ferrite; L_Axial_L11.0mm_D4.5mm_P7.62mm_Vertical_Fastron_MECC; Part N AWBC-09; DigiKey 535-12742-ND
R11, R13: 470R 1%; R_0603; Part N CRGCQ0603F470R; DigiKey A129684CT-ND
R12: 100R 1%; R_0603; Part N CRGP0603F100R; DigiKey A130404CT-ND
R27: 150R 1%; R_0603; Part N CRGCQ0603F150R; DigiKey A130404CT-ND
TP_3V3, TP_3V3A1: TEST_1P; SolderWirePad_single_1mmDrill
TP_-3V3A1: TEST_1P; SolderWirePad_single_1mmDrill
TP_GND1: TEST_1P; SolderWirePad_single_1mmDrill
TP_GNDA1: TEST_1P; SolderWirePad_single_1mmDrill
U4: LD1117S33TR; SOT-223; Part N LD1117S33TR; DigiKey 497-1242-1-ND
U5: LM2776DBV; LM2776; Part N LM2776DBVR; DigiKey 296-43957-1-ND

Connections:
+3V3: C10.1, C11.1, C14.1, C18.1, FB1.1, R12.2, TP_3V3.1, U4.2 (VO), U5.3 (VIN), U5.4 (EN); also elsewhere on the board
+3V3A: C15.1, FB1.2, TP_3V3A1.1; also elsewhere on the board
+5V: C8.1, C9.1, R11.1, U4.3 (VI); also elsewhere on the board
-3V3: C17.1, C19.2, FB2.1, R13.1, U5.1 (VOUT)
-3V3A: C20.2, FB2.2, TP_-3V3A1.1; also elsewhere on the board
GND: C8.2, C9.2, C10.2, C11.2, C14.2, C17.2, C18.2, C19.1, D2.1 (K), D3.1 (K), D4.2 (A), FB3.1, TP_GND1.1, U4.1 (GND), U5.2 (GND); also elsewhere on the board
GNDA: C15.2, C20.1, FB3.2, TP_GNDA1.1; also elsewhere on the board
unnamed: C16.1, U5.5 (C1+)
unnamed: C16.2, U5.6 (C1-)
unnamed: D2.2 (A), R11.2
unnamed: D3.2 (A), R12.1
unnamed: D4.1 (K), R27.2
unnamed: R13.2, R27.1

Notes on the sheet:
Aislacion D/A
LEDs Testigo
Inversor +3V3 -> -3V3
Considerar el uso de capacitores ceramicos multicapa SMD por la baja ESR. Para Cin usar por lo menos 2µF. Cout yo pondria 10µF. C1 recomienda 1µF Se pueden poner varios en paralelo para bajar la ESR. Si los +5V vienen de muy lejos (me parece que es nuestro caso) agregar un capa grande en paralelo
Regulacion a 3V3

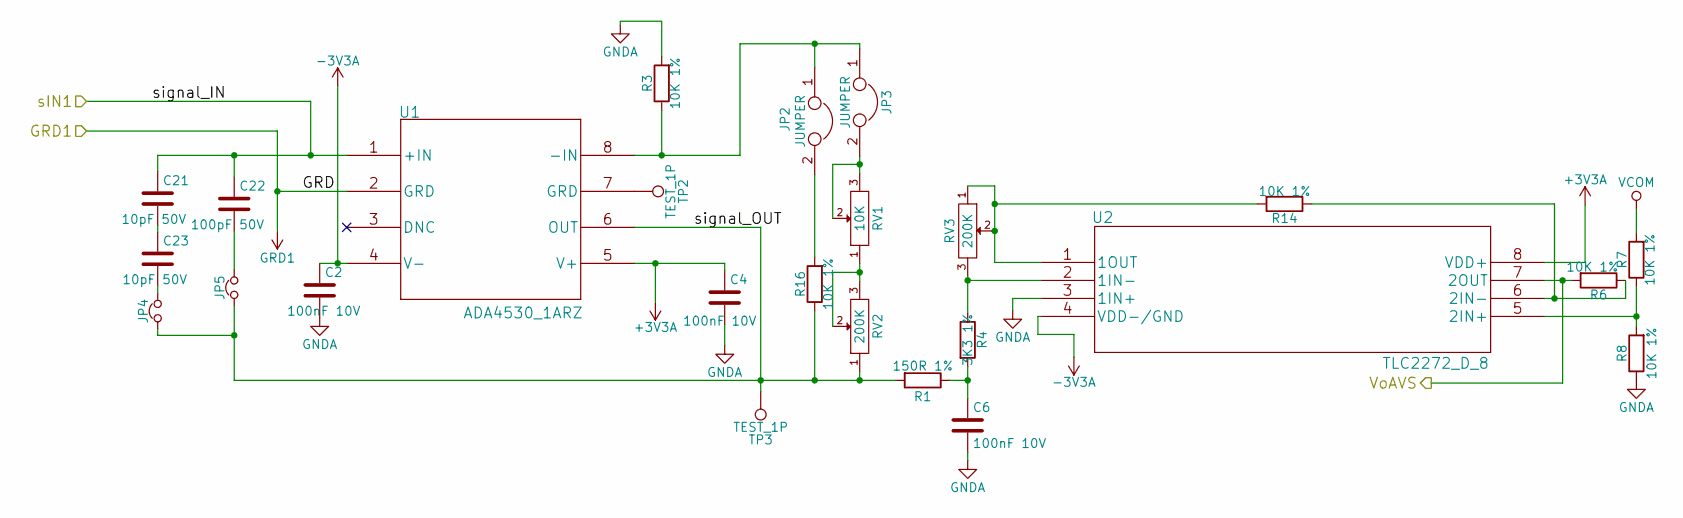
[picture p58: schematic EAI.sch]

Parts:
C2, C4, C6: 100nF 10V; C_0603; Part N 06033C104KAT4A; DigiKey 478-7018-2-ND
C21, C23: 10pF 50V; C_0805_HandSoldering; Part N 08055A100FAT2A; DigiKey 478-10493-1-ND
C22: 100pF 50V; C_0805_HandSoldering; Part N 08051A101FAT2A; DigiKey 478-3732-1-ND
JP2, JP3: JUMPER; Socket_Strip_Straight_1x02_Pitch2.00mm
JP4: J4; Pin_Header_Straight_1x02_Pitch2.00mm
JP5: J5; Socket_Strip_Straight_1x02_Pitch2.00mm
R1: 150R 1%; R_0603; Part N CRGCQ0603F150R; DigiKey A130404CT-ND
R3, R6, R7, R8, R14, R16: 10K 1%; R_0603; Part N CRG0603F10K; DigiKey A106048TR-ND
R4: 3K3 1%; R_0603; Part N CRGH0603F3K3; DigiKey A129543CT-ND
RV1: 10K; Potentiometer_Trimmer_Bourns_3269W; Part N 3269W-1-103GLF; DigiKey 3269W-1-103GLFCT-ND
RV2, RV3: 200K; Potentiometer_Trimmer_Vishay_TS53YJ; Part N TS53YL204MR10; DigiKey TS53YL-200KCT-ND
TP2, TP3: TEST_1P; SolderWirePad_single_1mmDrill
U1: ADA4530_1ARZ; Part N ADA4530-1ARZ; DigiKey ADA4530-1ARZ-ND
U2: TLC2272_D_8; Part N TLC2272ACDR; DigiKey 296-1303-1-ND

Connections:
+3V3A: C4.1, U1.5 (V+), U2.8 (VDD+); also elsewhere on the board
-3V3A: C2.1, U1.4 (V-), U2.4 (VDD-/GND); also elsewhere on the board
/ADC y salida SPI/VoAVS: R6.2, U2.7 (2OUT); also elsewhere on the board
/Campo Cercano_AVS/GRD1: U1.2 (GRD); also elsewhere on the board
/Campo Cercano_AVS/sIN1: C21.1, C22.1, U1.1 (+IN); also elsewhere on the board
/Campo Cercano_AVS/signal_OUT: JP4.2, JP5.1, R1.2, R16.1, RV2.1, TP3.1, U1.6 (OUT)
GNDA: C2.2, C4.2, C6.2, R3.2, R8.1, U2.3 (1IN+); also elsewhere on the board
unnamed: C6.1, R1.1, R4.2
unnamed: C21.2, C23.1
unnamed: C22.2, JP5.2
unnamed: C23.2, JP4.1
unnamed: JP2.1, JP3.1, R3.1, U1.8 (-IN)
unnamed: JP2.2, R16.2
unnamed: JP3.2, RV1.2, RV1.3
unnamed: R4.1, RV3.3, U2.2 (1IN-)
unnamed: R7.1, R8.2, U2.5 (2IN+)
unnamed: R6.1, R14.1, U2.6 (2IN-)
unnamed: R14.2, RV3.1, RV3.2, U2.1 (1OUT)
unnamed: RV1.1, RV2.2, RV2.3
unnamed: TP2.1, U1.7 (GRD)
VCOM: R7.2; also elsewhere on the board

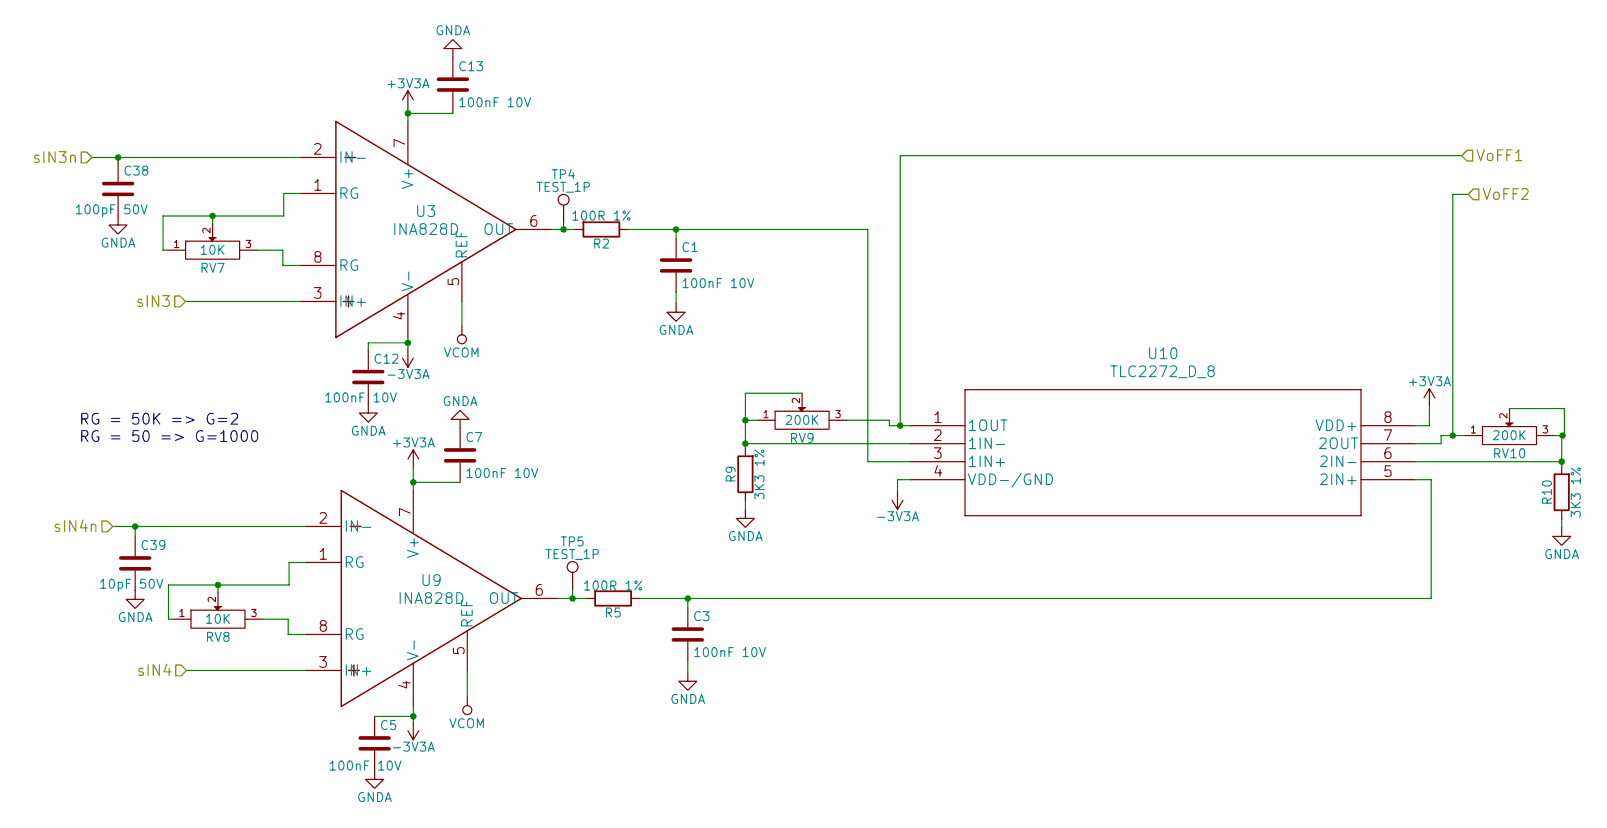
[picture p59: schematic IAmp1.sch]

Parts:
C1, C3, C5, C7, C12, C13: 100nF 10V; C_0603; Part N 06033C104KAT4A; DigiKey 478-7018-2-ND
C38: 100pF 50V; C_0805_HandSoldering; Part N 08051A101FAT2A; DigiKey 478-3732-1-ND
C39: 10pF 50V; C_0805_HandSoldering; Part N 08055A100FAT2A; DigiKey 478-10493-1-ND
R2, R5: 100R 1%; R_0603; Part N CRGP0603F100R; DigiKey A130404CT-ND
R9, R10: 3K3 1%; R_0603; Part N CRGH0603F3K3; DigiKey A129543CT-ND
RV7, RV8: 10K; Potentiometer_Trimmer_Bourns_3269W; Part N 3269W-1-103GLF; DigiKey 3269W-1-103GLFCT-ND
RV9, RV10: 200K; Potentiometer_Trimmer_Vishay_TS53YJ; Part N TS53YL204MR10; DigiKey TS53YL-200KCT-ND
TP4, TP5: TEST_1P; SolderWirePad_single_1mmDrill
U3, U9: INA828D; INA828IDR; Part N INA828IDR; DigiKey 296-48914-1-ND
U10: TLC2272_D_8; Part N TLC2272ACDR; DigiKey 296-1303-1-ND

Connections:
+3V3A: C7.2, C13.2, U3.7 (V+), U9.7 (V+), U10.8 (VDD+); also elsewhere on the board
-3V3A: C5.1, C12.1, U3.4 (V-), U9.4 (V-), U10.4 (VDD-/GND); also elsewhere on the board
/ADC y salida SPI/VoFF1: RV9.3, U10.1 (1OUT); also elsewhere on the board
/ADC y salida SPI/VoFF2: RV10.1, U10.7 (2OUT); also elsewhere on the board
/CampoLejano1/sIN3: U3.3 (IN+); also elsewhere on the board
/CampoLejano1/sIN3n: C38.1, U3.2 (IN-); also elsewhere on the board
/CampoLejano1/sIN4: U9.3 (IN+); also elsewhere on the board
/CampoLejano1/sIN4n: C39.1, U9.2 (IN-); also elsewhere on the board
GNDA: C1.2, C3.2, C5.2, C7.1, C12.2, C13.1, C38.2, C39.2, R9.1, R10.1; also elsewhere on the board
unnamed: C1.1, R2.1, U10.3 (1IN+)
unnamed: C3.1, R5.1, U10.5 (2IN+)
unnamed: R2.2, TP4.1, U3.6 (OUT)
unnamed: R5.2, TP5.1, U9.6 (OUT)
unnamed: R9.2, RV9.1, RV9.2, U10.2 (1IN-)
unnamed: R10.2, RV10.2, RV10.3, U10.6 (2IN-)
unnamed: RV7.1, RV7.2, U3.1 (RG)
unnamed: RV7.3, U3.8 (RG)
unnamed: RV8.1, RV8.2, U9.1 (RG)
unnamed: RV8.3, U9.8 (RG)
VCOM: U3.5 (REF), U9.5 (REF); also elsewhere on the board

Notes on the sheet:
RG = 50K => G=2 RG = 50 => G=1000

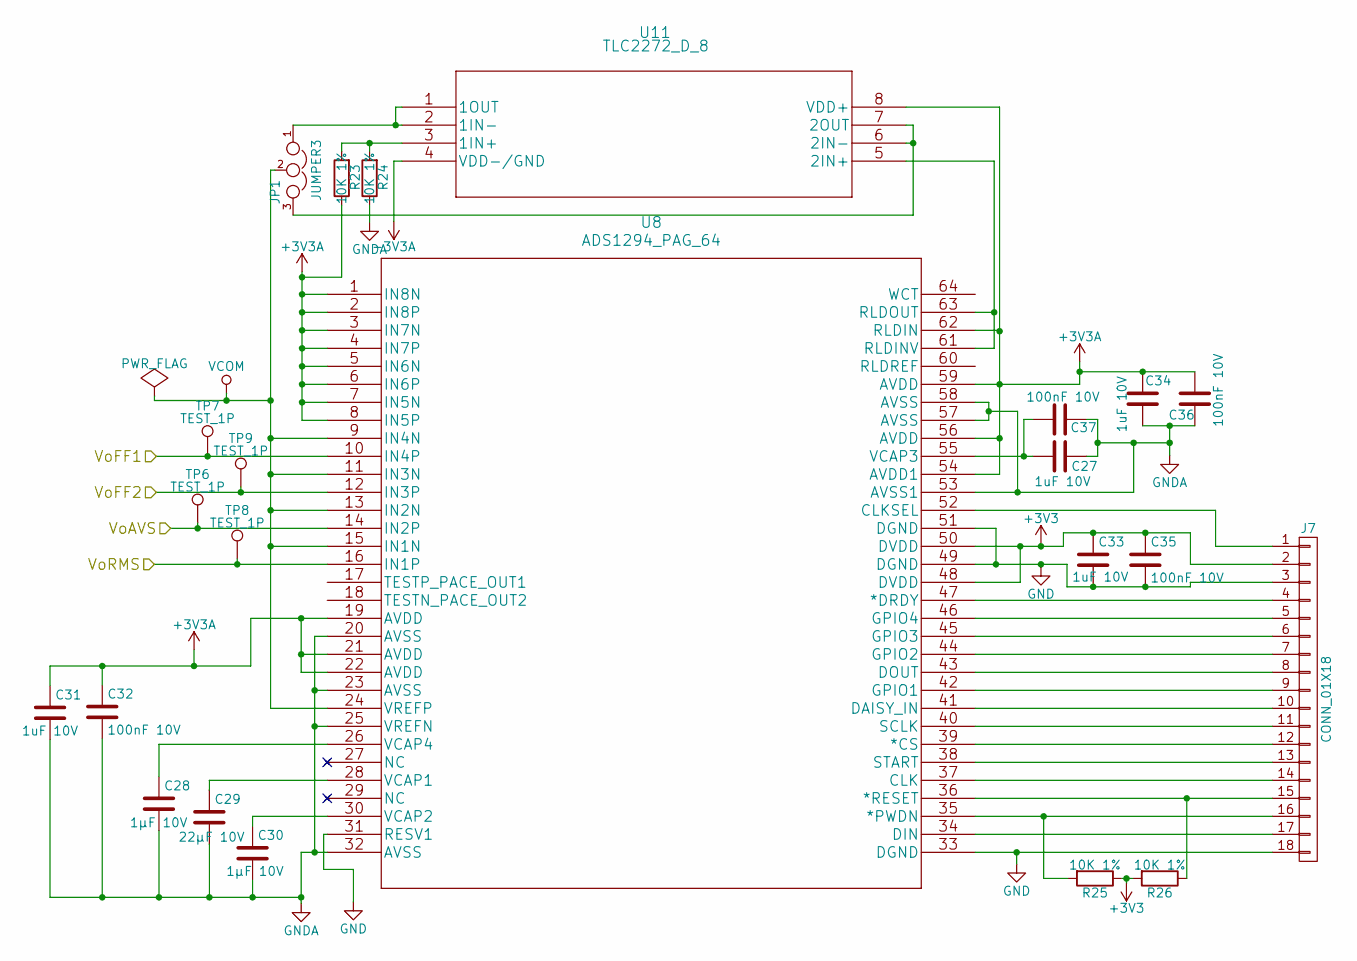
[picture p60: schematic ADC.sch]

Parts:
C27, C31, C33, C34: 1uF 10V; C_0603; Part N CL10A105MP8NNNC; DigiKey 1276-1866-2-ND
C28, C30: 1µF 10V; C_0603; Part N CL10A105MP8NNNC; DigiKey 1276-1866-2-ND
C29: 22µF 10V; C_0603; Part N CL10A226MPCNUBE; DigiKey 1276-6504-1-ND
C32, C35, C36, C37: 100nF 10V; C_0603; Part N 06033C104KAT4A; DigiKey 478-7018-2-ND
J7: CONN_01X18; IDC-Header_2x10_Pitch2.54mm_Angled
JP1: JUMPER3; Pin_Header_Straight_1x03_Pitch2.00mm
R23, R24, R25, R26: 10K 1%; R_0603; Part N CRG0603F10K; DigiKey A106048TR-ND
TP6, TP7, TP8, TP9: TEST_1P; SolderWirePad_single_1mmDrill
U8: ADS1294_PAG_64; ADS1294; Part N ADS1294IPAG; DigiKey 296-27932-ND
U11: TLC2272_D_8; Part N TLC2272ACDR; DigiKey 296-1303-1-ND

Connections:
+3V3: C33.1, C35.1, J7.2, R25.1, R26.2, U8.48 (DVDD), U8.50 (DVDD); also elsewhere on the board
+3V3A: C31.1, C32.1, C34.1, C36.1, R23.1, U8.1 (IN8N), U8.2 (IN8P), U8.3 (IN7N), U8.4 (IN7P), U8.5 (IN6N), U8.6 (IN6P), U8.7 (IN5N), U8.8 (IN5P), U8.19 (AVDD), U8.21 (AVDD), U8.22 (AVDD), U8.54 (AVDD1), U8.56 (AVDD), U8.59 (AVDD), U8.62 (RLDIN), U11.8 (VDD+); also elsewhere on the board
-3V3A: U11.4 (VDD-/GND); also elsewhere on the board
/ADC y salida SPI/VoAVS: TP6.1, U8.14 (IN2P); also elsewhere on the board
/ADC y salida SPI/VoFF1: TP7.1, U8.10 (IN4P); also elsewhere on the board
/ADC y salida SPI/VoFF2: TP9.1, U8.12 (IN3P); also elsewhere on the board
/ADC y salida SPI/VoRMS: TP8.1, U8.16 (IN1P); also elsewhere on the board
GND: C33.2, C35.2, J7.3, J7.18, U8.31 (RESV1), U8.33 (DGND), U8.49 (DGND), U8.51 (DGND); also elsewhere on the board
GNDA: C27.1, C28.2, C29.2, C30.2, C31.2, C32.2, C34.2, C36.2, C37.1, R24.1, U8.20 (AVSS), U8.23 (AVSS), U8.25 (VREFN), U8.32 (AVSS), U8.53 (AVSS1), U8.57 (AVSS), U8.58 (AVSS); also elsewhere on the board
unnamed: C27.2, C37.2, U8.55 (VCAP3)
unnamed: C28.1, U8.26 (VCAP4)
unnamed: C29.1, U8.28 (VCAP1)
unnamed: C30.1, U8.30 (VCAP2)
unnamed: J7.1, U8.52 (CLKSEL)
unnamed: J7.4, U8.47 (*DRDY)
unnamed: J7.5, U8.46 (GPIO4)
unnamed: J7.6, U8.45 (GPIO3)
unnamed: J7.7, U8.44 (GPIO2)
unnamed: J7.8, U8.43 (DOUT)
unnamed: J7.9, U8.42 (GPIO1)
unnamed: J7.10, U8.41 (DAISY_IN)
unnamed: J7.11, U8.40 (SCLK)
unnamed: J7.12, U8.39 (*CS)
unnamed: J7.13, U8.38 (START)
unnamed: J7.14, U8.37 (CLK)
unnamed: J7.15, R26.1, U8.36 (*RESET)
unnamed: J7.16, R25.2, U8.35 (*PWDN)
unnamed: J7.17, U8.34 (DIN)
unnamed: JP1.1, U11.1 (1OUT), U11.2 (1IN-)
unnamed: JP1.3, U11.6 (2IN-), U11.7 (2OUT)
unnamed: R23.2, R24.2, U11.3 (1IN+)
unnamed: U8.61 (RLDINV), U8.63 (RLDOUT), U11.5 (2IN+)
VCOM: JP1.2, U8.9 (IN4N), U8.11 (IN3N), U8.13 (IN2N), U8.15 (IN1N), U8.24 (VREFP); also elsewhere on the board

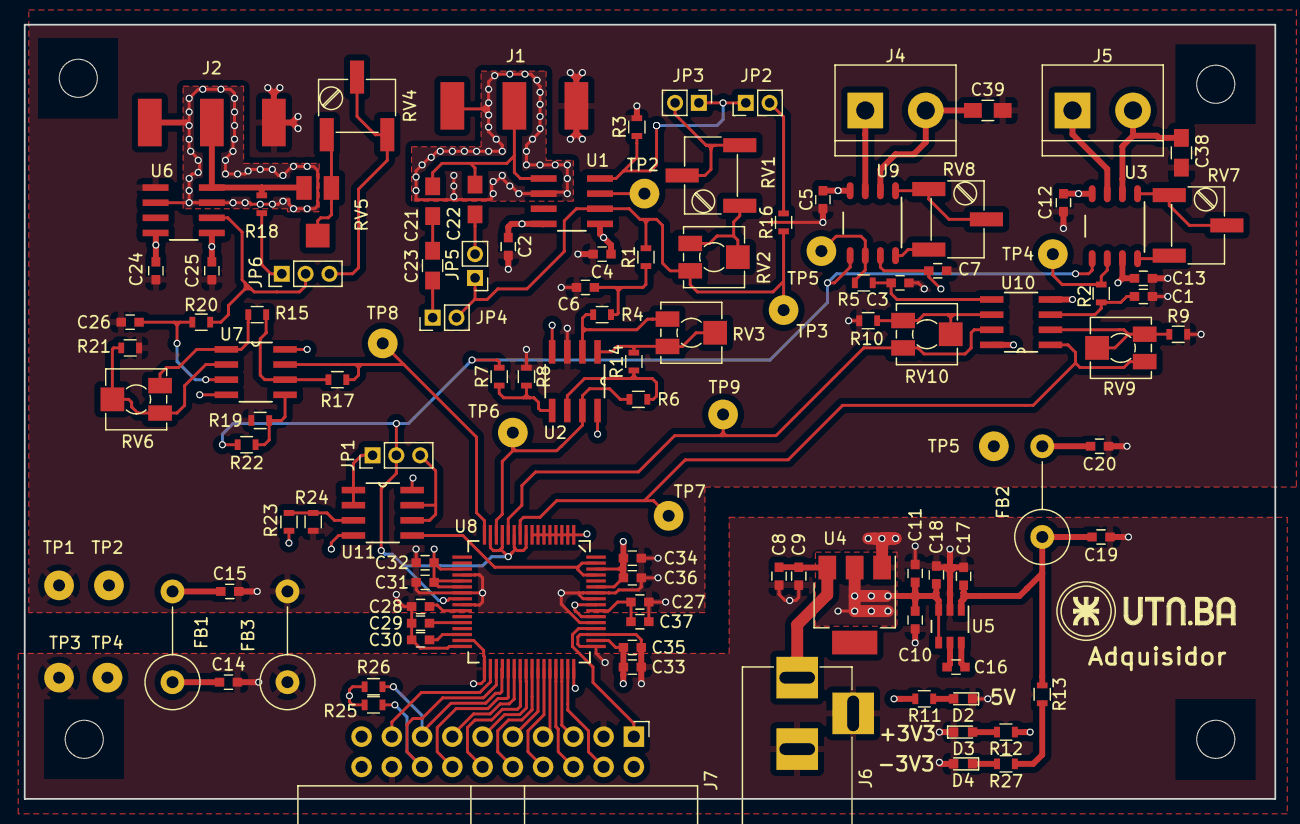
[picture p61: board FrontEnd.kicad_pcb from above]

Board: 4 copper layers, 105.0 x 65.0 mm, 118 parts (0 on the bottom side), 82 nets.

Other parts of the board:
TP1, TP2#2, TP3#2, TP4#2, TP5#2: TEST_1P; SolderWirePad_single_1mmDrill

Their connections:
+3V3: TP4#2.1; also elsewhere on the board
+3V3A: TP2#2.1; also elsewhere on the board
-3V3A: TP5#2.1; also elsewhere on the board
GND: TP3#2.1; also elsewhere on the board
GNDA: TP1.1; also elsewhere on the board
