brunogle/me1-proyecto/soft/ADS1115_Capture/Core/Src/main.c

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
/* Includes ------------------------------------------------------------------*/
#include "main.h"

/* USER CODE BEGIN Includes */
#include <inttypes.h>
#include <string.h>
#include <stdio.h>

#include "stm32f4xx_hal_tim.h"

/* USER CODE END Includes */

/* USER CODE BEGIN PD */


#define CONTROL_BYTE_W 0b10010000
#define CONTROL_BYTE_R 0b10010001

#define CONFIG_REG_ADDR 0x01
#define LOW_THRESHOLD_RED_ADDR 0x02
#define HIGH_THROSHOLD_REG_ADDR 0x03


#define CONFIG_REG_MSB 0b11000011
#define CONFIG_REG_LSB 0b11100000


/* USER CODE END PD */

I2C_HandleTypeDef hi2c1;

UART_HandleTypeDef huart2;

void SystemClock_Config(void);
static void MX_GPIO_Init(void);
static void MX_USART2_UART_Init(void);
static void MX_I2C1_Init(void);
/* USER CODE BEGIN 0 */


void ADS1115_INIT(void)
{

	uint8_t i2c_tx_data[3];


	//CONFIG
	i2c_tx_data[0]= CONFIG_REG_ADDR; //Conf Reg Address
	i2c_tx_data[1] = CONFIG_REG_MSB; //MSB Conf Reg
	i2c_tx_data[2] = CONFIG_REG_LSB; //LSB Conf Reg
	HAL_I2C_Master_Transmit(&hi2c1, CONTROL_BYTE_W, i2c_tx_data, 3*8, HAL_MAX_DELAY);
	HAL_Delay(20);

	i2c_tx_data[0] = LOW_THRESHOLD_RED_ADDR; //Lo-threshold Register Address
	i2c_tx_data[1] = 0x00; //MSB lo-t Reg
	i2c_tx_data[2] = 0x00; //LSB lo-t Reg
	HAL_I2C_Master_Transmit(&hi2c1, CONTROL_BYTE_W, i2c_tx_data, 3*8, HAL_MAX_DELAY);
	HAL_Delay(20);

	i2c_tx_data[0] = HIGH_THROSHOLD_REG_ADDR; //Hi-threshold Register Address
	i2c_tx_data[1] = 0xFF; //MSB hi-t Reg
	i2c_tx_data[2] = 0xFF; //LSB hi-t Reg
	HAL_I2C_Master_Transmit(&hi2c1, CONTROL_BYTE_W, i2c_tx_data, 3*8, HAL_MAX_DELAY);
	HAL_Delay(20);


	//TxBuffer[0] = 0x00; //Conversion Register Address
	//HAL_I2C_Master_Transmit(&hi2c1, CONTROL_BYTE_W, TxBuffer, 8, HAL_MAX_DELAY);
	//HAL_Delay(20);


}



void HAL_GPIO_EXTI_Callback(uint16_t GPIO_Pin){

	if(GPIO_Pin == DRDY_Pin)
	{

		char tx_value_str[12];
		uint8_t i2c_rx_data[2];

		HAL_I2C_Mem_Read(&hi2c1, CONTROL_BYTE_R, 0, 1, i2c_rx_data, 2, HAL_MAX_DELAY);

		uint16_t conversion_value = (i2c_rx_data[0] << 8) | (i2c_rx_data[1]);

		uint16_t nbytes = sprintf(tx_value_str, "%d\n\r", conversion_value);

		HAL_UART_Transmit(&huart2, tx_value_str, nbytes, HAL_MAX_DELAY);

	}

}


void TIM4_IRQHandler(TIM_HandleTypeDef *htim){
  if(TIM4->SR & TIM_SR_UIF)
  {

	HAL_GPIO_WritePin(LD2_GPIO_Port, LD2_Pin, 1);

	uint8_t i2c_tx_data[3];

	i2c_tx_data[0]= CONFIG_REG_ADDR; //Conf Reg Address
	i2c_tx_data[1] = CONFIG_REG_MSB; //MSB Conf Reg
	i2c_tx_data[2] = CONFIG_REG_LSB; //LSB Conf Reg Para 860SPS


	HAL_I2C_Master_Transmit(&hi2c1, CONTROL_BYTE_W, i2c_tx_data, 3*8, HAL_MAX_DELAY);
	HAL_GPIO_WritePin(LD2_GPIO_Port, LD2_Pin, 0);
	TIM4->SR &= 0;

  }

}



/* USER CODE END 0 */

/**
  * @brief  The application entry point.
  * @retval int
  */
int main(void)
{
  /* MCU Configuration--------------------------------------------------------*/

  /* Reset of all peripherals, Initializes the Flash interface and the Systick. */
  HAL_Init();

  /* Configure the system clock */
  SystemClock_Config();

  /* Initialize all configured peripherals */
  MX_GPIO_Init();
  MX_USART2_UART_Init();
  MX_I2C1_Init();
  /* USER CODE BEGIN 2 */

  ADS1115_INIT();


  //Configuro manualmente TIM4 para samplear a 500SPS.
  //El generador de codigo de STM32CubeIDE no funciona... :(

  RCC->APB1ENR |= RCC_APB1ENR_TIM4EN;
  TIM4->PSC = 2	;
  TIM4->ARR = 55999;
  TIM4->DIER |= TIM_DIER_UIE;
  TIM4->SR &= ~TIM_SR_UIF;
  NVIC_EnableIRQ(TIM4_IRQn);
  HAL_NVIC_SetPriority(TIM4_IRQn, 0, 0);
  TIM4->CR1 |= TIM_CR1_CEN;


  /* USER CODE END 2 */

  /* Infinite loop */
  /* USER CODE BEGIN WHILE */
  while (1)
  {
    /* USER CODE END WHILE */

    /* USER CODE BEGIN 3 */


  }
  /* USER CODE END 3 */
}

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
