brunogle/me1-proyecto/soft/ADS1115_Capture/ADS1115_Capture.ioc

Mcu.UserName=STM32F401RETx
PA0-WKUP.GPIO_Label=DRDY_OLD
PA0-WKUP.Signal=GPXTI0
PA1.GPIO_Label=DRDY
PA1.Signal=GPXTI1
PA2.GPIO_Label=USART_TX
PA2.Signal=USART2_TX
PA3.GPIO_Label=USART_RX
PA3.Signal=USART2_RX
PA5.GPIO_Label=LD2 [Green Led]
PA5.Signal=GPIO_Output
PB6.Signal=I2C1_SCL
PB7.Signal=I2C1_SDA
