brunogle/me1-proyecto/soft/ADS1115_Capture/Core/Inc/main.h

#define DRDY_OLD_Pin GPIO_PIN_0
#define DRDY_OLD_GPIO_Port GPIOA
#define DRDY_OLD_EXTI_IRQn EXTI0_IRQn
#define DRDY_Pin GPIO_PIN_1
#define DRDY_GPIO_Port GPIOA
#define DRDY_EXTI_IRQn EXTI1_IRQn
#define USART_TX_Pin GPIO_PIN_2
#define USART_TX_GPIO_Port GPIOA
#define USART_RX_Pin GPIO_PIN_3
#define USART_RX_GPIO_Port GPIOA
#define LD2_Pin GPIO_PIN_5
#define LD2_GPIO_Port GPIOA
