brunogle/me1-proyecto/(commit log)

2023-10-05 Primer commit, funciones basicas para el ADC
2023-10-05 Agregue diseño del PCB
    [.sch.sch, ADC-2023-05-05-18-58-41.sch, ADC-2023-05-06-03-14-55.sch, ADC-2023-05-11-01-00-13.sch, ADC-2023-05-11-22-55-20.sch, ADC-2023-10-04-15-00-56.sch, ADC-2023-10-04-15-01-24.sch, ADC.kicad_pcb]
2024-02-12 Cambio a proyecto: ECG. Listo para entregar paper
    [.sch.sch, ADC-2023-05-05-18-58-41.sch, ADC-2023-05-06-03-14-55.sch, ADC-2023-05-11-01-00-13.sch, ADC-2023-05-11-22-55-20.sch, ADC-2023-10-04-15-00-56.sch, ADC-2023-10-04-15-01-24.sch, ADC.kicad_pcb]
2024-02-16 D13 pulse during timer interrupt
2024-02-18 Mejoras de codigo, comentarios
2024-03-02 Mayoria de correciones en el paper, analisis extra en calibracion
2024-04-24 Comienzo de correcciones de v3
