brunogle/me1-proyecto/(notices)

Notices in the files:
soft/ADS1115_Capture/Core/Inc/main.h:
Copyright (c) 2023 STMicroelectronics.
All rights reserved.
This software is licensed under terms that can be found in the LICENSE file
parts and their libraries:
Copyright 2016 Accelerated Designs. All rights reserved.
